pressla/I2C-Bus-extender/pics/2020-06-28_17-43-44.png

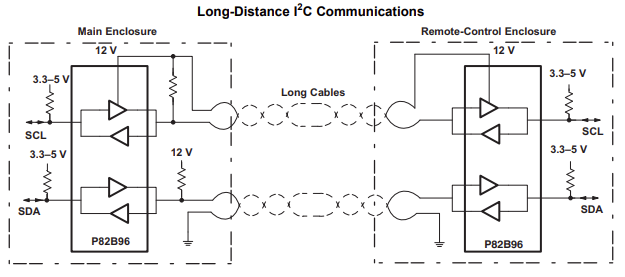
pics/2020-06-28_17-43-44.png
