pressla/I2C-Bus-extender/pics/20200618_094727.jpg

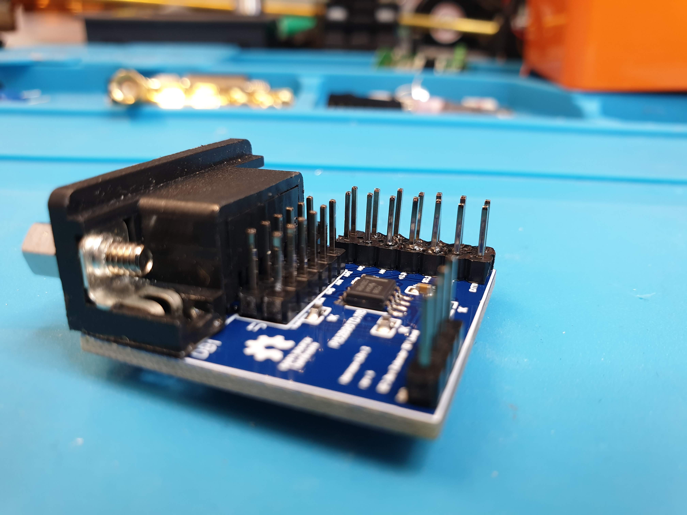
pics/20200618_094727.jpg
