pressla/I2C-Bus-extender/pics/20200618_102856.jpg

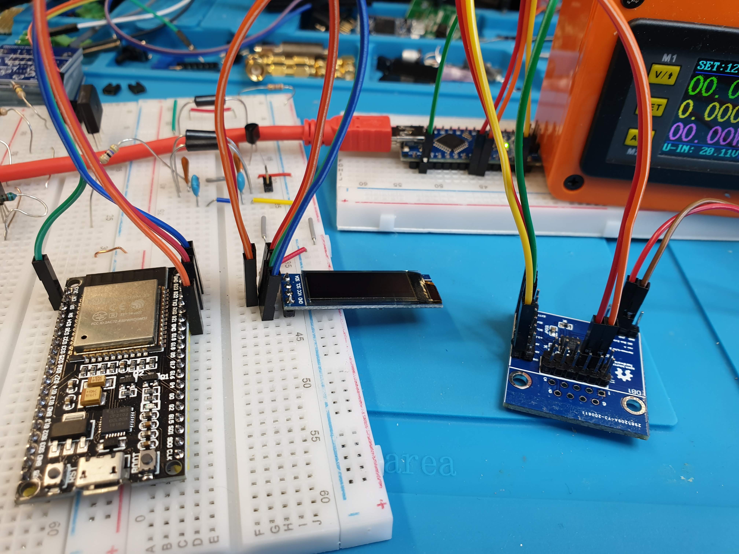
pics/20200618_102856.jpg
