pressla/I2C-Bus-extender/pics/20200618_102927.jpg

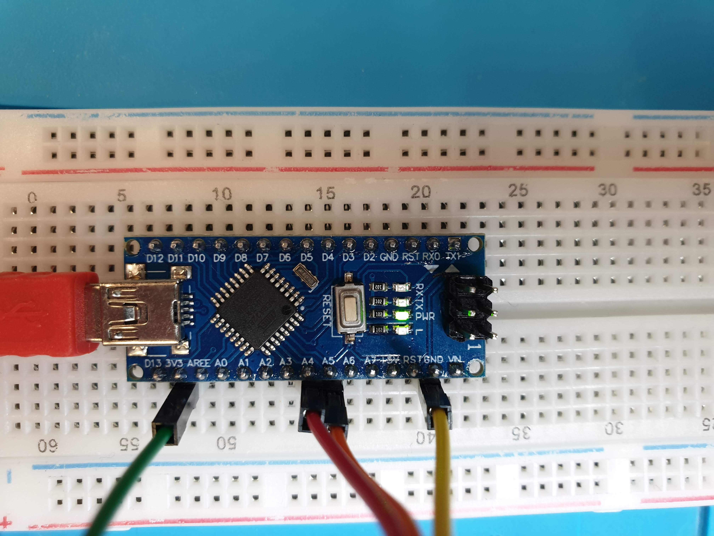
pics/20200618_102927.jpg
