pressla/I2C-Bus-extender/pics/20200618_220154.jpg

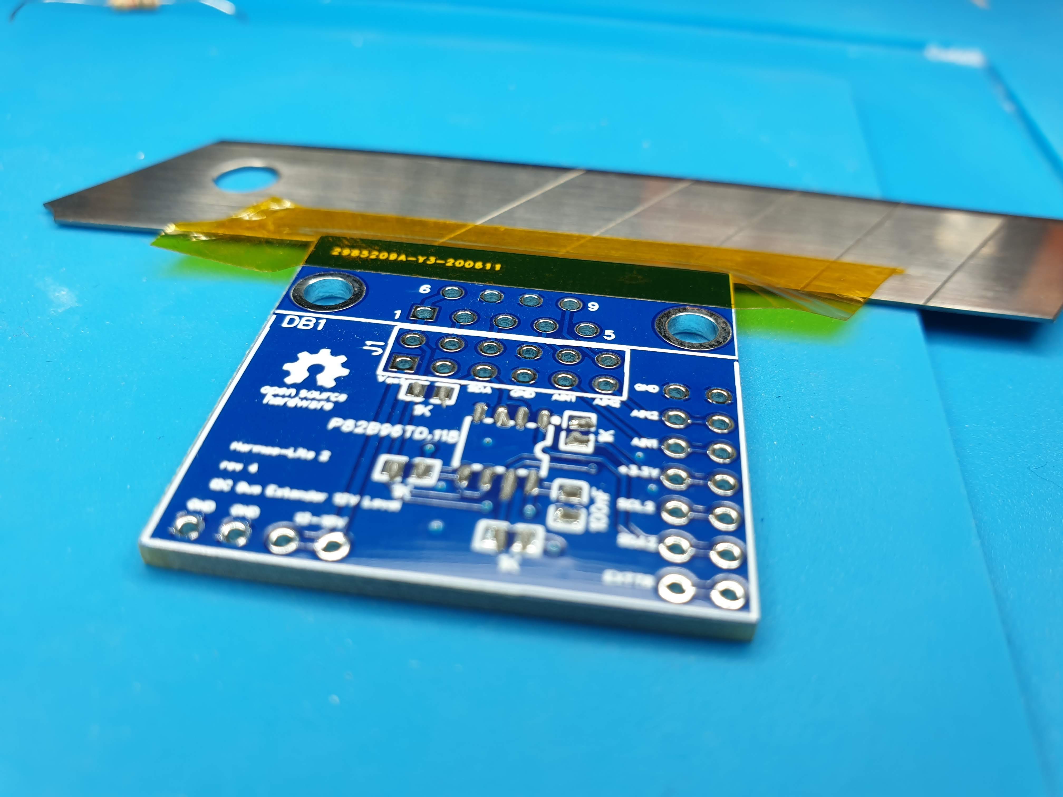
pics/20200618_220154.jpg
