pressla/I2C-Bus-extender/pics/20200618_222724.jpg

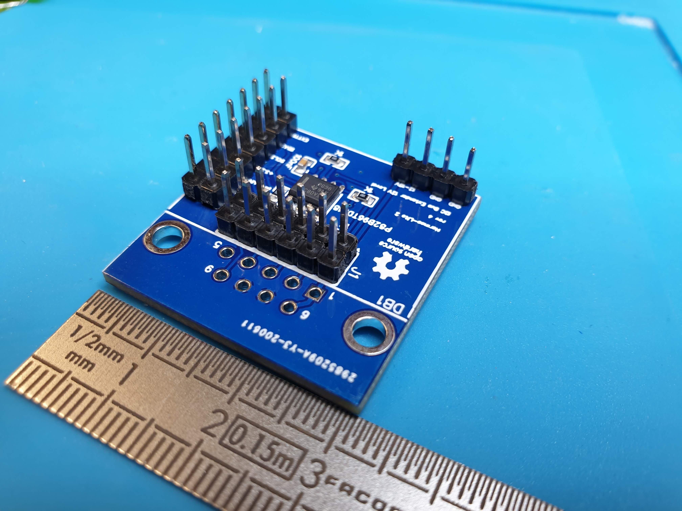
pics/20200618_222724.jpg
