pressla/I2C-Bus-extender/pics/20200627_005624.jpg

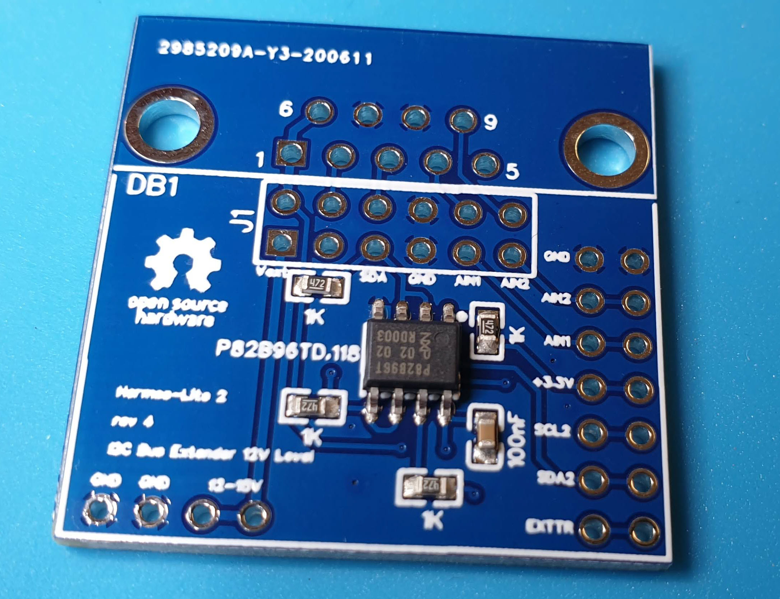
pics/20200627_005624.jpg
