pressla/I2C-Bus-extender/pics/20200627_010358.jpg

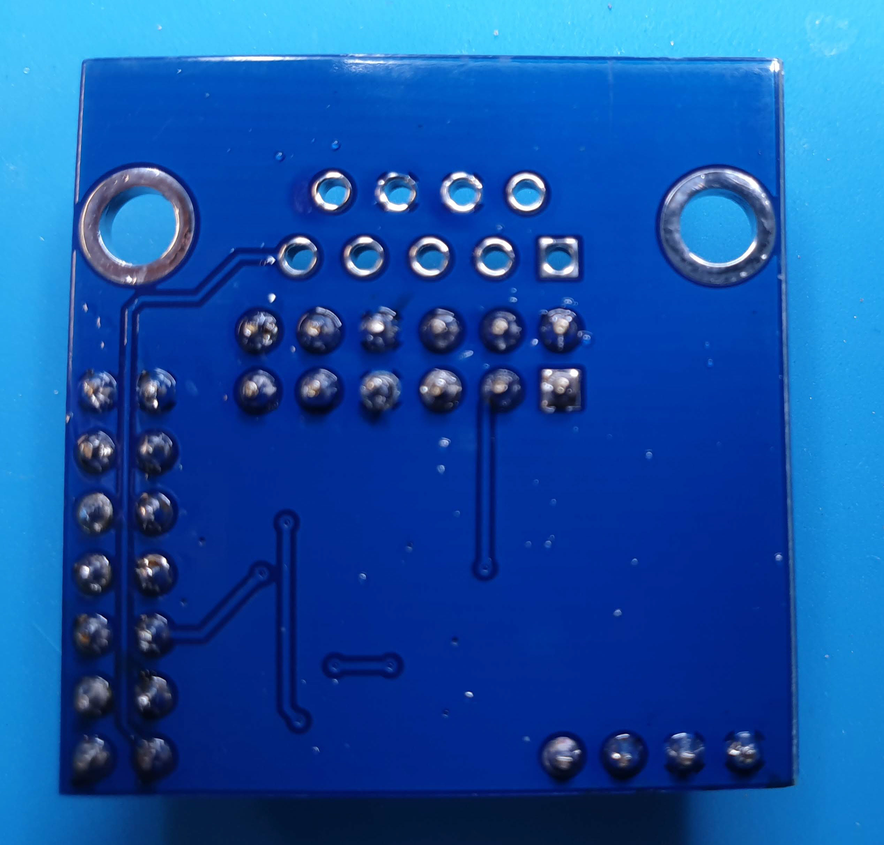
pics/20200627_010358.jpg
