pressla/I2C-Bus-extender/pics/20200627_011011.jpg

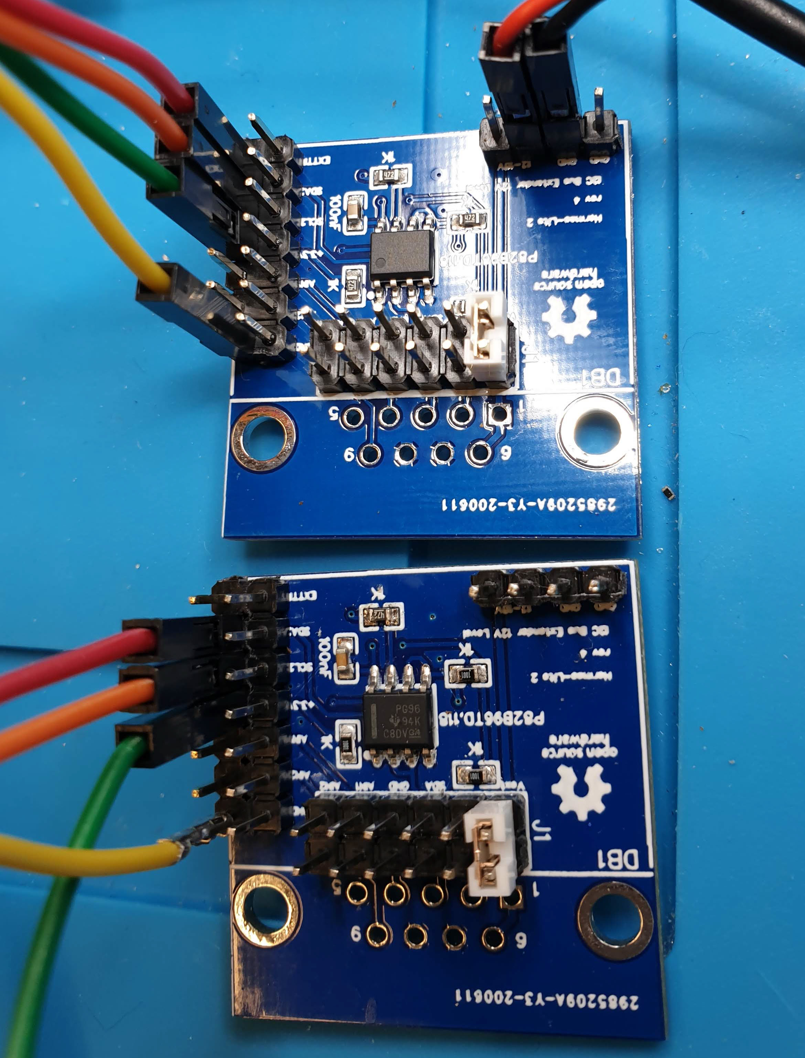
pics/20200627_011011.jpg
