pressla/I2C-Bus-extender/pics/20200627_011023.jpg

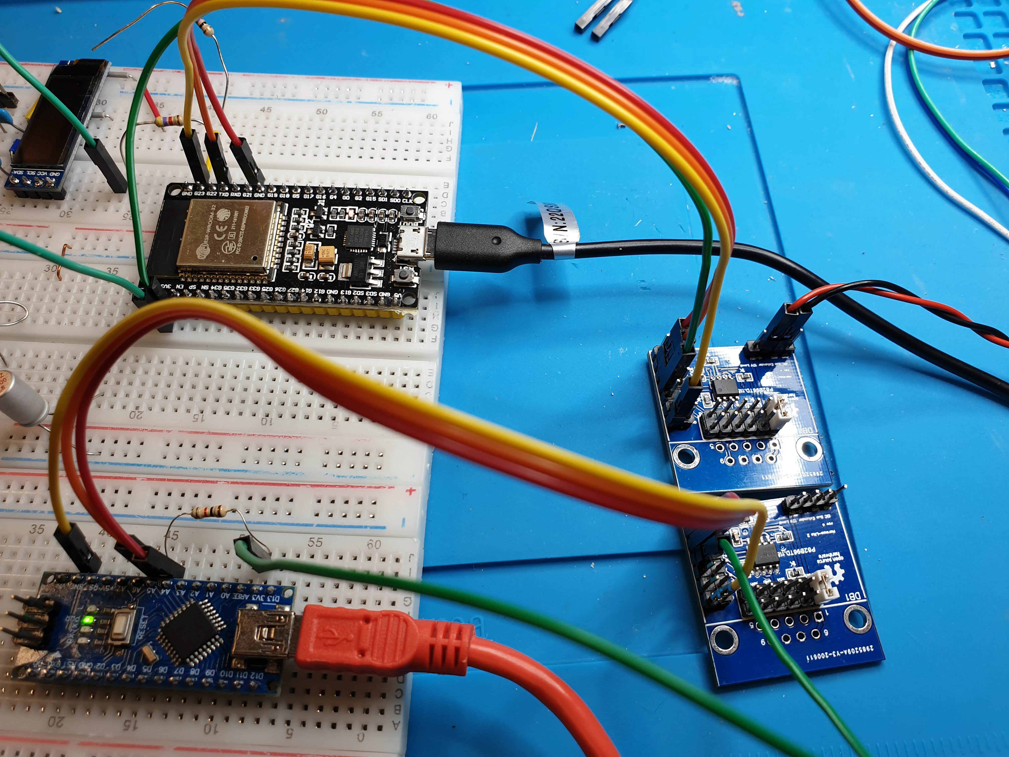
pics/20200627_011023.jpg
