pressla/I2C-Bus-extender/pics/20200627_020842.jpg

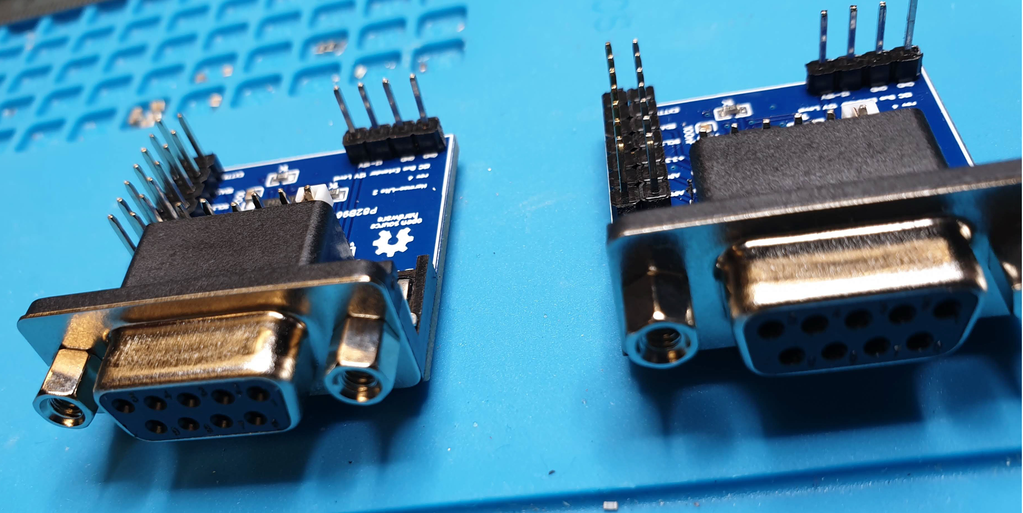
pics/20200627_020842.jpg
