pressla/I2C-Bus-extender/pics/20200627_021142.jpg

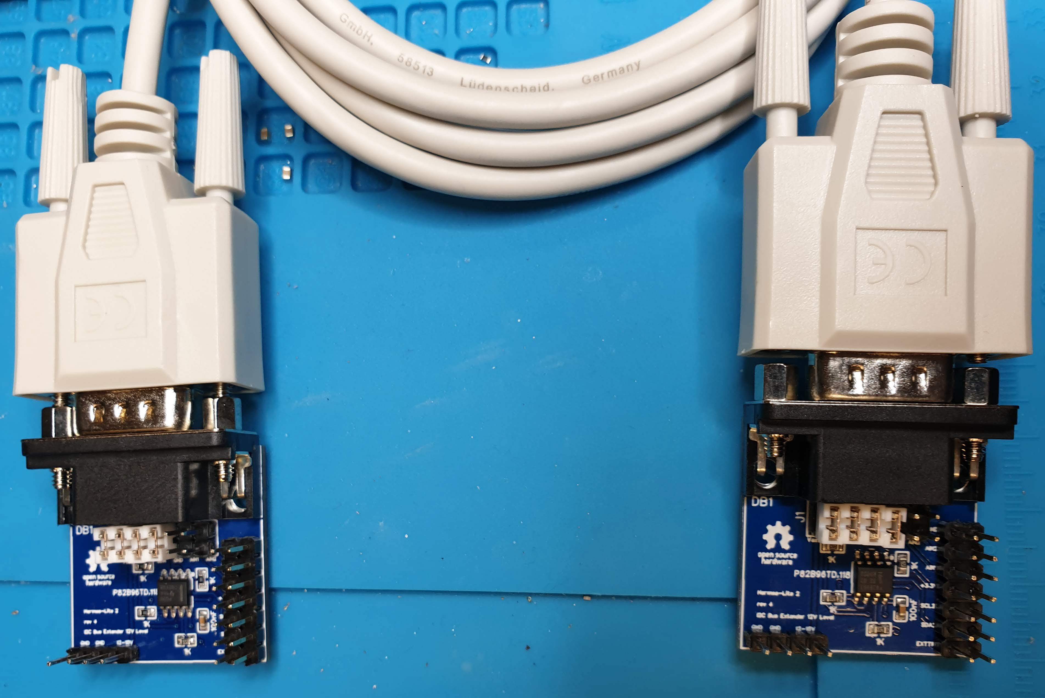
pics/20200627_021142.jpg
