pressla/I2C-Bus-extender/pics/20200627_225102.jpg

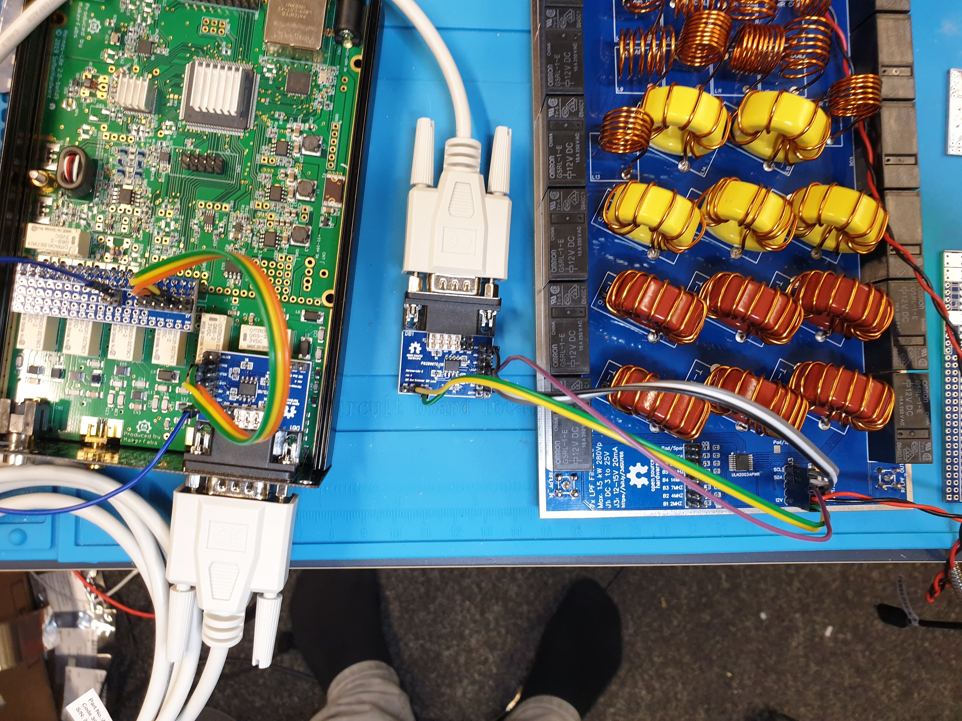
pics/20200627_225102.jpg
