pressla/I2C-Bus-extender/pics/20200627_225112.jpg

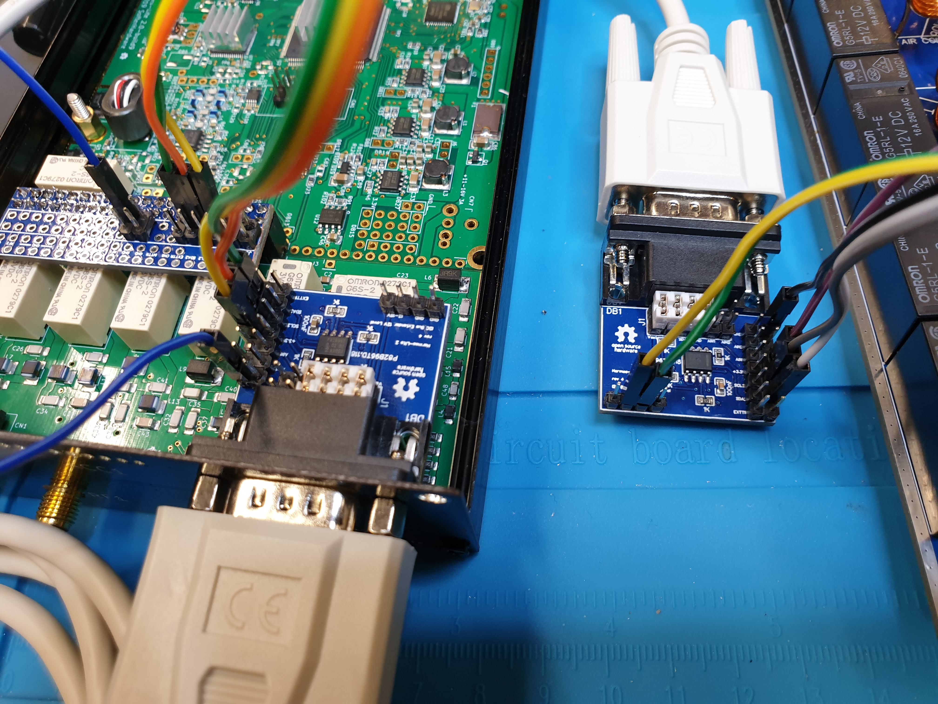
pics/20200627_225112.jpg
