pressla/I2C-Bus-extender/pics/20200627_225741.jpg

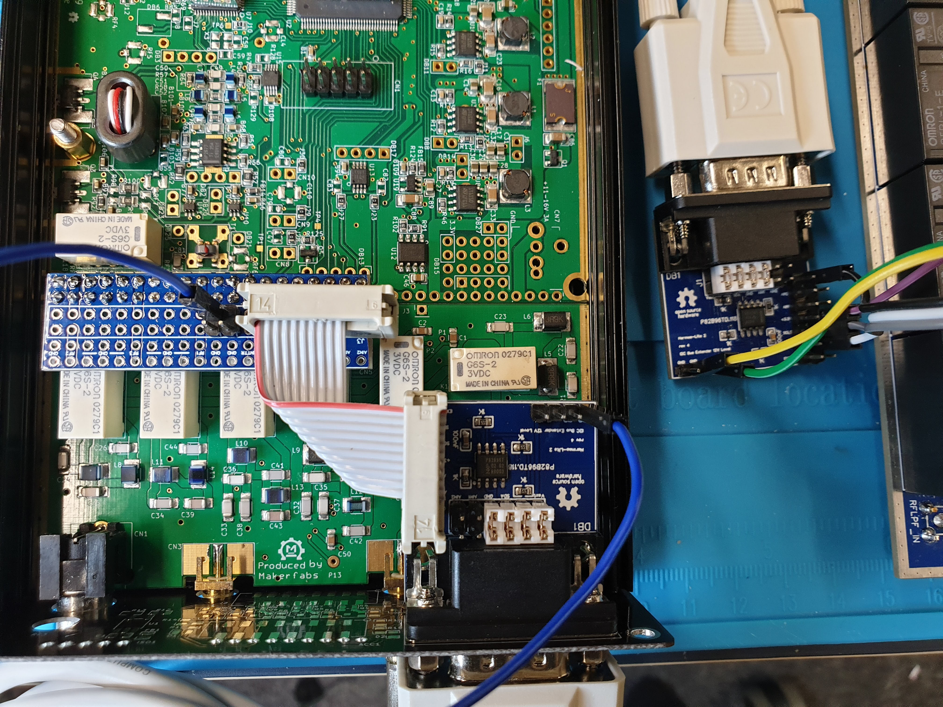
pics/20200627_225741.jpg
