pressla/I2C-Bus-extender/pics/pcb-top.png

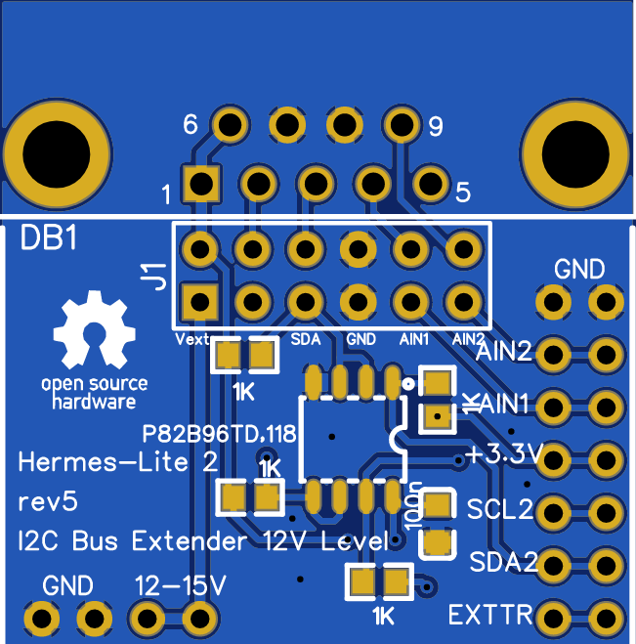
pics/pcb-top.png
