pressla/I2C-Bus-extender/pics/20200627_175204.jpg

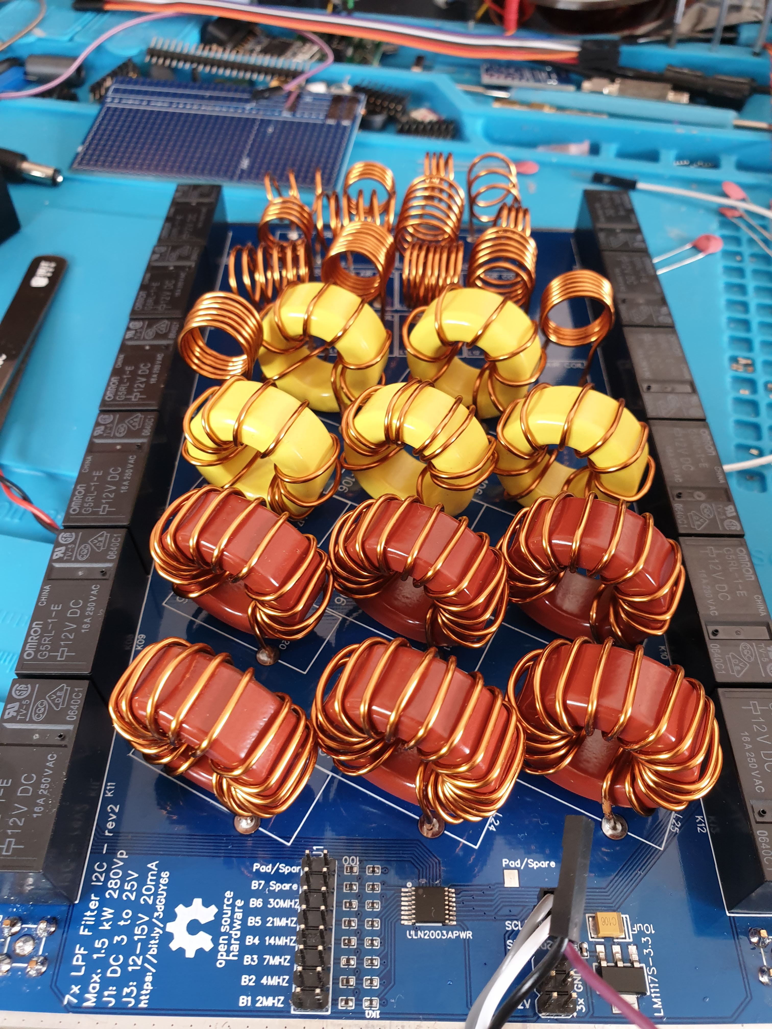
pics/20200627_175204.jpg
